OneWireHomeAutomation/programable_io_8/README.md

# programable_io_8
board with 8 programmable input/output channels
