OneWireHomeAutomation/programable_io_8/pio8.brd

## EAGLE design pio8.brd (2017-01-17)

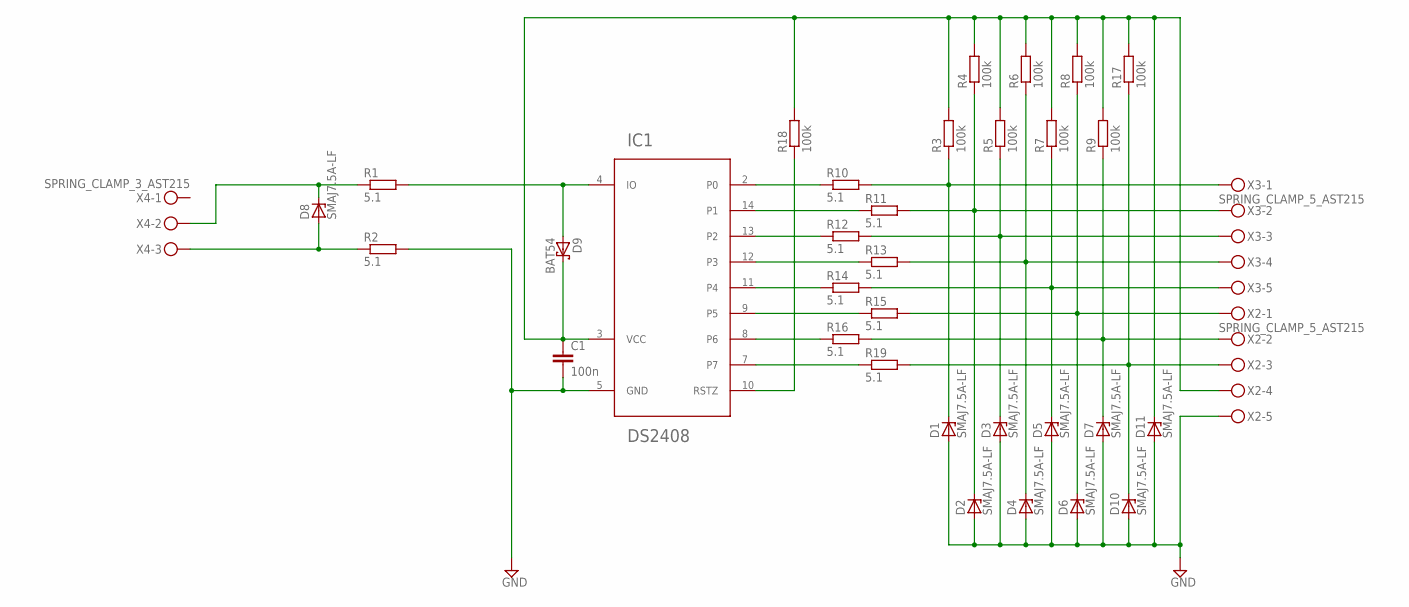
[picture p1: schematic pio8.sch]

Parts:
C1: 100n; C0402K
D1, D2, D3, D4, D5, D6, D7, D8, D10, D11: SMAJ7.5A-LF; DO214AC
D9: BAT54; SOT23
IC1: DS2408; SO16
R1, R2, R10, R11, R12, R13, R14, R15, R16, R19: 5.1; R0402
R3, R4, R5, R6, R7, R8, R9, R17, R18: 100k; R0402
X2, X3: SPRING_CLAMP_5_AST215; AST215_5
X4: SPRING_CLAMP_3_AST215; AST215_3

Connections:
GND: C1.2, D1.A, D2.A, D3.A, D4.A, D5.A, D6.A, D7.A, D10.A, D11.A, IC1.5 (GND), R2.2, X2.5A, X2.5B
unnamed: D1.C, R3.1, R10.2, X3.1A, X3.1B
unnamed: D2.C, R4.1, R11.2, X3.2A, X3.2B
unnamed: D3.C, R5.1, R12.2, X3.3A, X3.3B
unnamed: D4.C, R6.1, R13.2, X3.4A, X3.4B
unnamed: D5.C, R7.1, R14.2, X3.5A, X3.5B
unnamed: D6.C, R8.1, R15.2, X2.1A, X2.1B
unnamed: D7.C, R9.1, R16.2, X2.2A, X2.2B
unnamed: IC1.2 (P0), R10.1
unnamed: D8.A, R2.1, X4.3A, X4.3B
unnamed: D8.C, R1.1, X4.2A, X4.2B
unnamed: C1.1, D9.3 (C), D11.C, IC1.3 (VCC), R3.2, R4.2, R5.2, R6.2, R7.2, R8.2, R9.2, R17.2, R18.2, X2.4A, X2.4B
unnamed: D10.C, R17.1, R19.2, X2.3A, X2.3B
unnamed: IC1.14 (P1), R11.1
unnamed: IC1.13 (P2), R12.1
unnamed: IC1.12 (P3), R13.1
unnamed: IC1.11 (P4), R14.1
unnamed: IC1.9 (P5), R15.1
unnamed: IC1.8 (P6), R16.1
unnamed: IC1.7, R19.1
unnamed: D9.1 (A), IC1.4 (IO), R1.2
unnamed: IC1.10 (RSTZ), R18.1

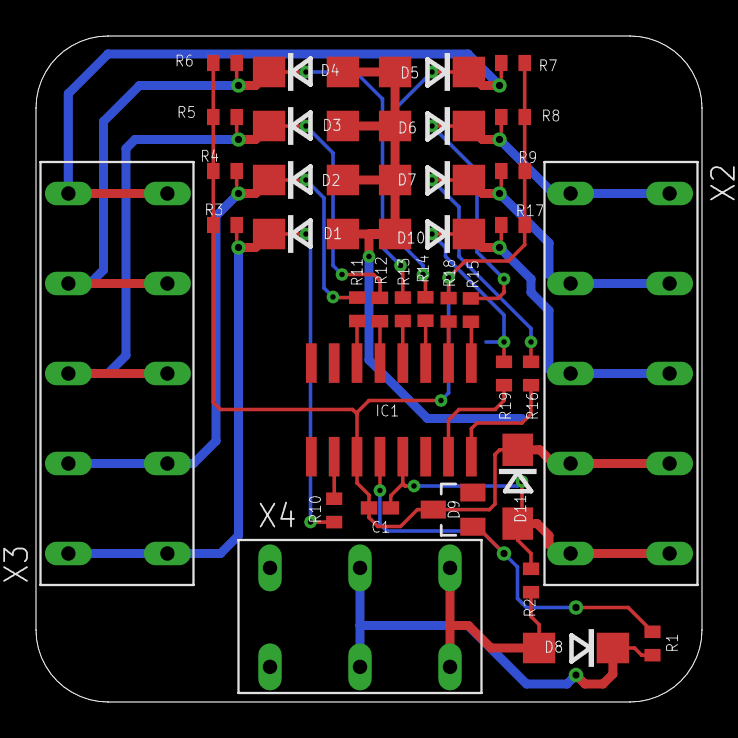
[picture p2: board pio8.brd from above]

Board: 2 copper layers, 37.0 x 37.0 mm, 35 parts (0 on the bottom side), 22 nets.
