OneWireHomeAutomation/programable_io_8/(threads)

Thread 1 (2016-06-18):

connectors do not fit

ch-aurich, 2016-06-18:
The PCB itself is ok but when connecting plugs to X1, X7 and X8 they collide - the screw terminals overlap at the corners where the connectors are closest to each other

ch-aurich, 2016-06-18:
Here is a foto to show the problem 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
