OneWireHomeAutomation/programable_io_8/(commit log)

2016-06-07 adding first release of the pio8 board
    [pio8.brd, pio8.sch]
2016-06-10 changing some values: 5 Ohm resistor to 5.1 Ohm (5 Ohm is not broadly available) selected different type of TVS diode with essentially the same ratings
    [pio8.brd, pio8.sch]
2016-06-10 adding cairocffi to install section of .travis.yml to get eagle-bom.py working
2016-06-18 rotating connectors to resolve issue #1 while maintaining IO and GND/VCC pinout but rotating pinout for the one wire connector (to keep the pin numbering the same as other 1-wire devices have)
    [pio8.brd, pio8.sch]
2016-06-18 changing the connector solution for the digital i/o's - now using spring clamp terminals instead of pluggable screw terminals. The new ones should reduce the width. Also turning back the 3 pin connec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
    [pio8.brd, pio8.sch]
2017-01-17 changing 1-wire connector to a spring clamp type
    [pio8.brd, pio8.sch]
